CharelF01/CREPO1/README.md

# CREPO1
This project was done in the scope of the BTS-Internet of Things in the Lycée des Arts et Métiers Luxembourg.
The Creative Project 1's objective was to create a robotic arm that can move a small object in a defined space and lift it at least 10cm.

Mark received on Project: 16/20
