CharelF01/CREPO1/Design/HandAssembly.SLDASM

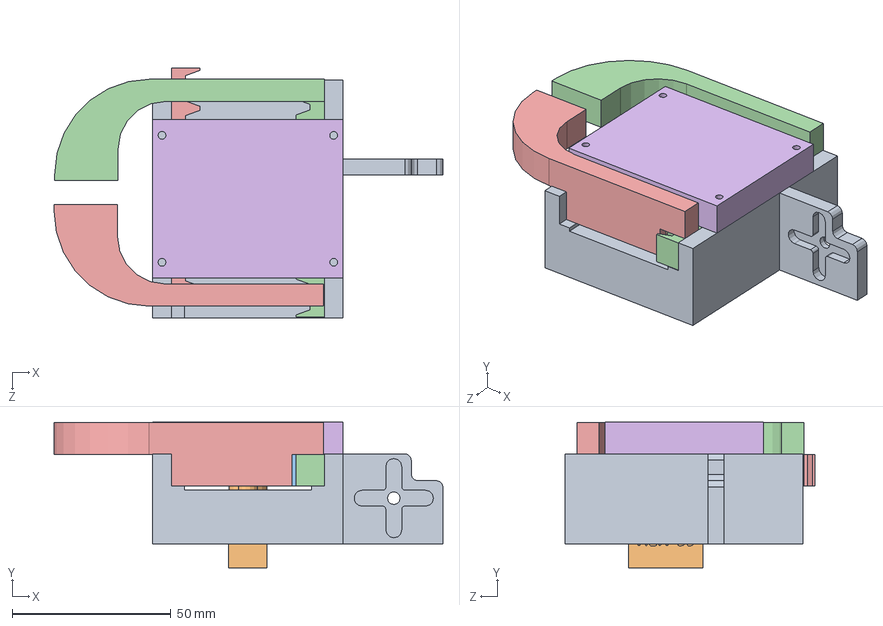
[picture p37: CAD file, 2023-04-04]
Design/HandAssembly.SLDASM
122.6 x 46.0 x 78.7 mm
HandConnect
Servo Modster MEX55
FingerLeftPart
FingerRightPart
spur gear_iso
