CharelF01/CREPO1/Design/Motor_Connection.SLDPRT

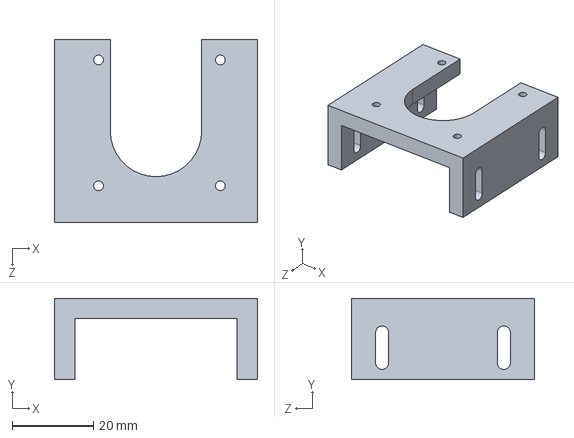
[picture p38: CAD file, 2023-04-04]
Design/Motor_Connection.SLDPRT
50.0 x 20.0 x 45.0 mm
