CharelF01/CREPO1/Design/FingerRightPart.SLDPRT

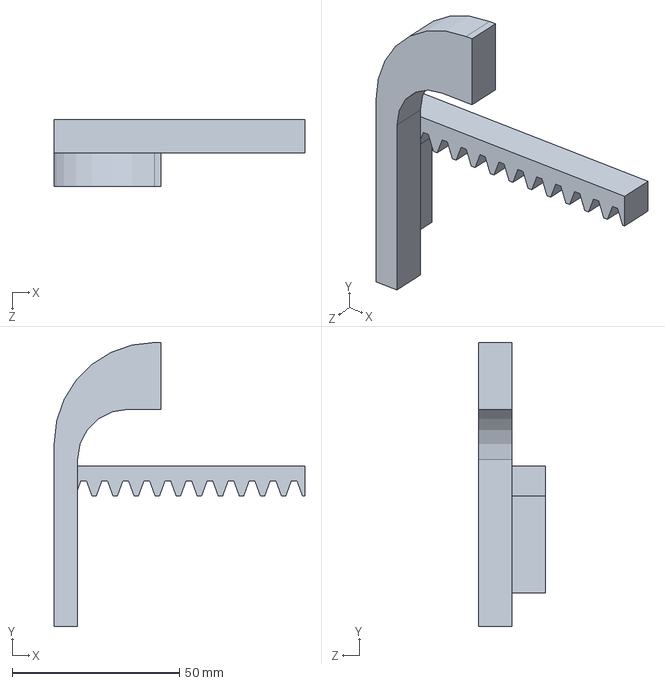
[picture p39: CAD file, 2023-04-04]
Design/FingerRightPart.SLDPRT
75.0 x 85.0 x 20.0 mm
