CharelF01/CREPO1/Design/kugel lager holder.SLDPRT

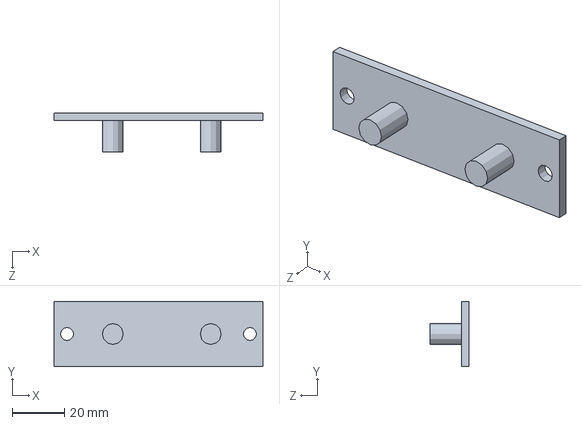
[picture p40: CAD file, 2023-04-04]
Design/kugel lager holder.SLDPRT
80.0 x 25.0 x 15.0 mm
