CharelF01/CREPO1/Design/Part1.SLDPRT

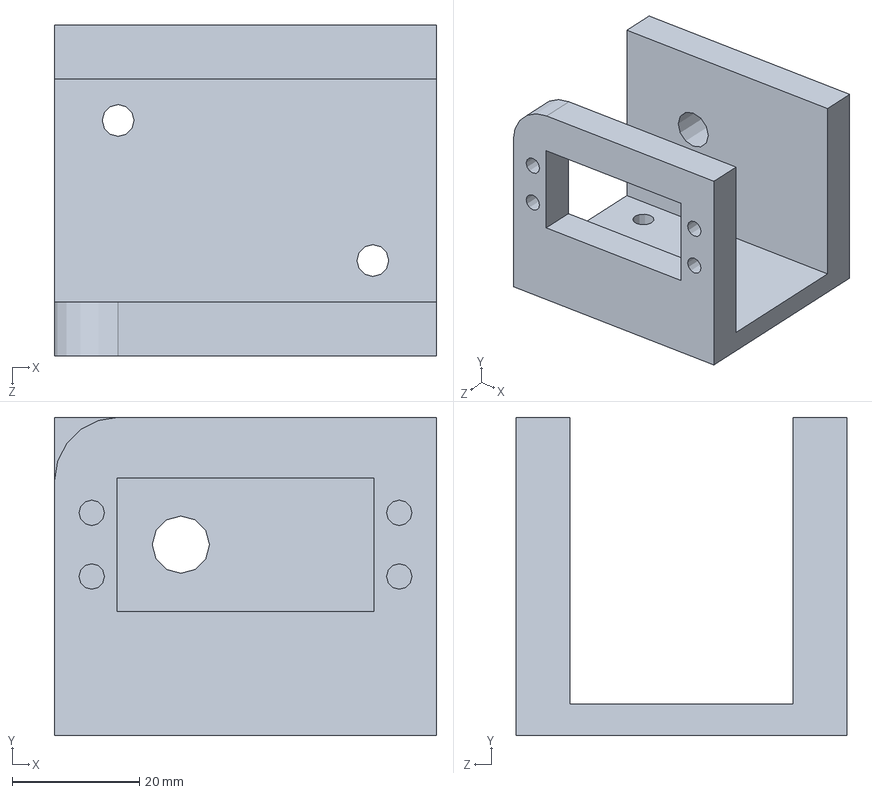
[picture p41: CAD file, 2023-04-04]
Design/Part1.SLDPRT
60.0 x 50.0 x 52.0 mm
