CharelF01/CREPO1/Design/SeitenstückStepper.SLDPRT

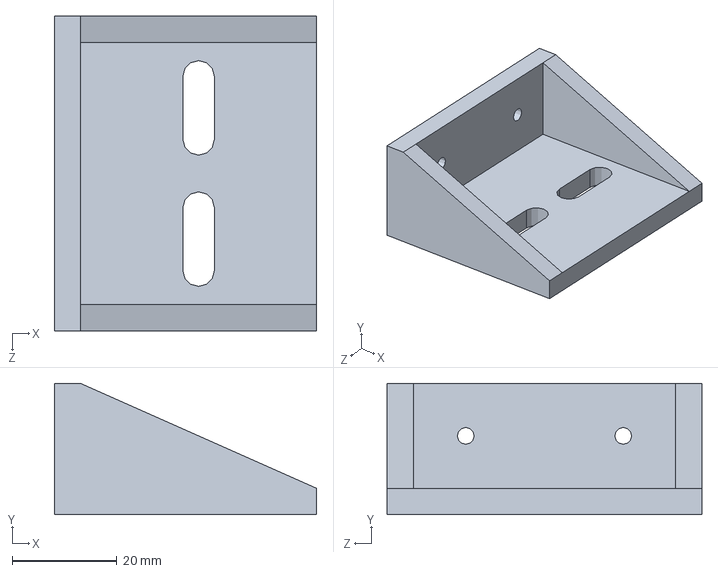
[picture p42: CAD file, 2023-04-04]
Design/SeitenstückStepper.SLDPRT
50.0 x 25.0 x 60.0 mm
