CharelF01/CREPO1/Design/ArmPart2.SLDPRT

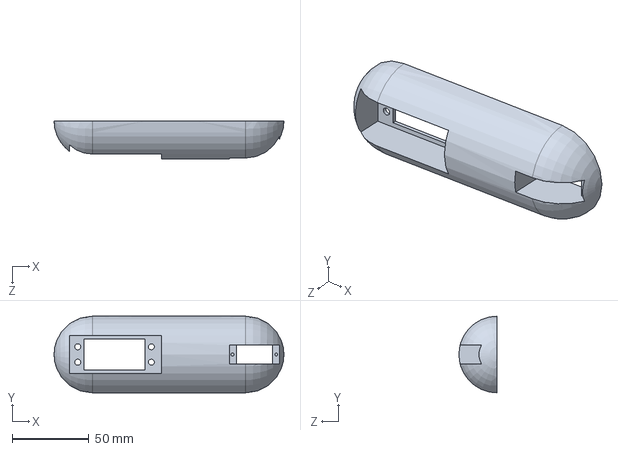
[picture p43: CAD file, 2023-04-04]
Design/ArmPart2.SLDPRT
150.0 x 50.0 x 25.0 mm
