CharelF01/CREPO1/Design/Deckel.SLDPRT

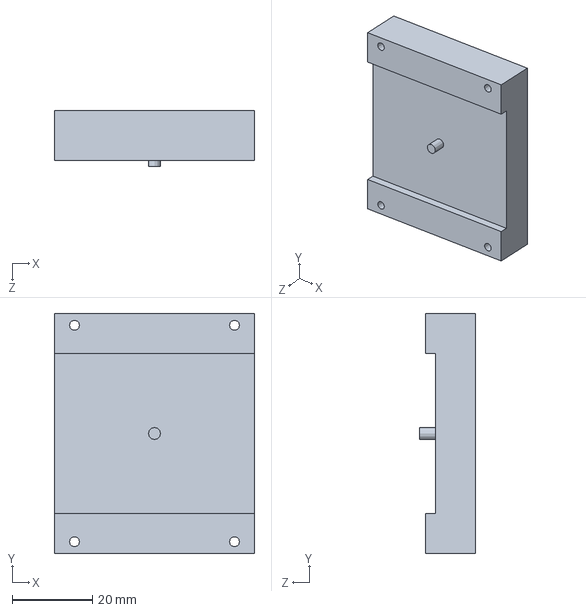
[picture p44: CAD file, 2023-04-04]
Design/Deckel.SLDPRT
50.0 x 60.0 x 14.0 mm
