CharelF01/CREPO1/Design/ArmPart1Draft.SLDPRT

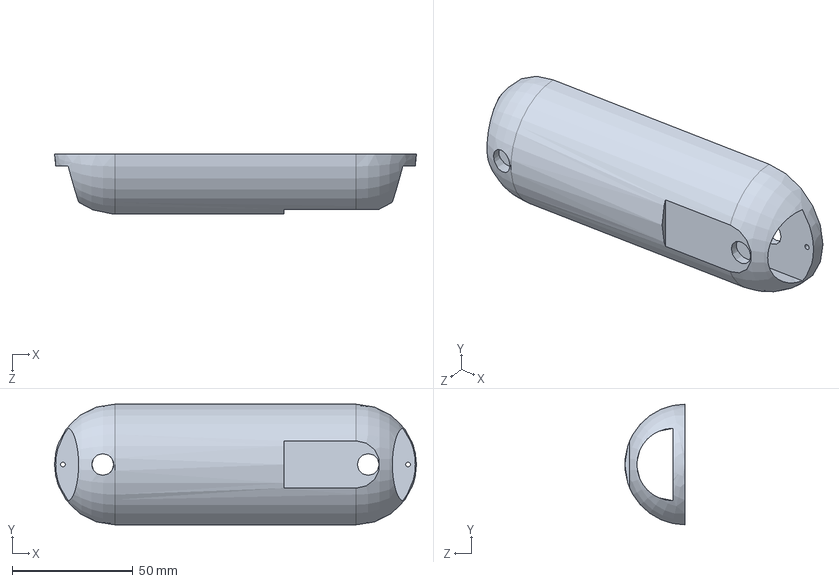
[picture p45: CAD file, 2023-04-04]
Design/ArmPart1Draft.SLDPRT
150.0 x 50.0 x 25.0 mm
