CharelF01/CREPO1/Design/HandConnect.SLDPRT

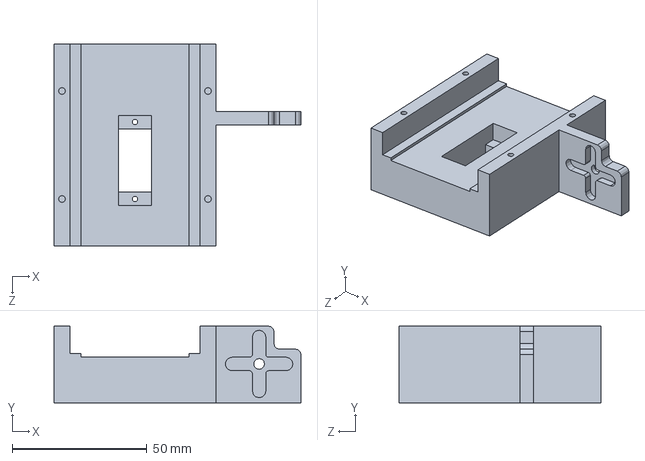
[picture p46: CAD file, 2023-04-04]
Design/HandConnect.SLDPRT
91.5 x 28.4 x 75.0 mm
