CharelF01/CREPO1/Design/stepper holder.SLDPRT

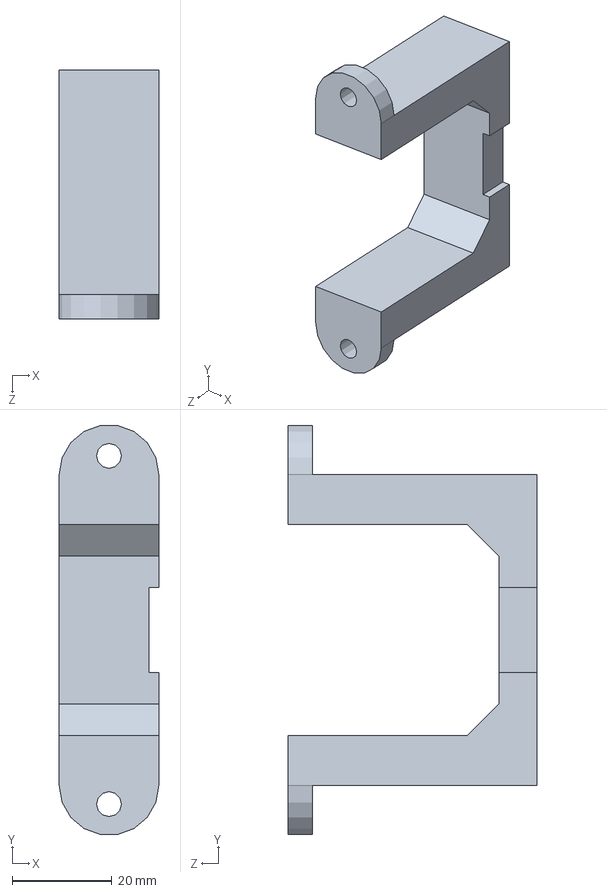
[picture p47: CAD file, 2023-04-04]
Design/stepper holder.SLDPRT
20.0 x 82.0 x 50.0 mm
