CharelF01/CREPO1/Design/Capstogethr.SLDPRT

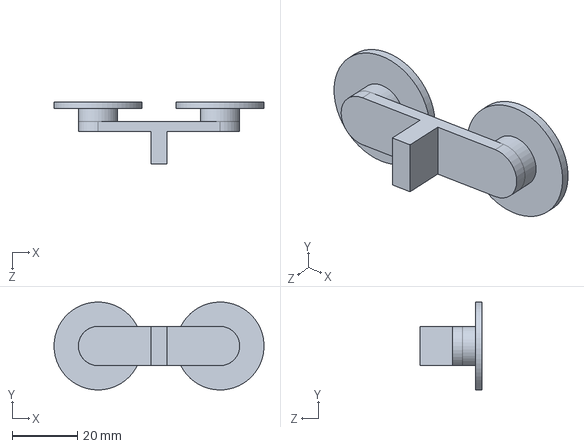
[picture p48: CAD file, 2023-04-04]
Design/Capstogethr.SLDPRT
64.5 x 27.0 x 19.0 mm
