CharelF01/CREPO1/(list of files, cad)

Other CAD files:
Design/FingerLeftPart.SLDPRT
